sparkybrit/sram-breadboard-adapter/sram-breadboard-adaptor.kicad_pcb

## KiCad design sram-breadboard-adaptor.kicad_pcb (2026-11-08)

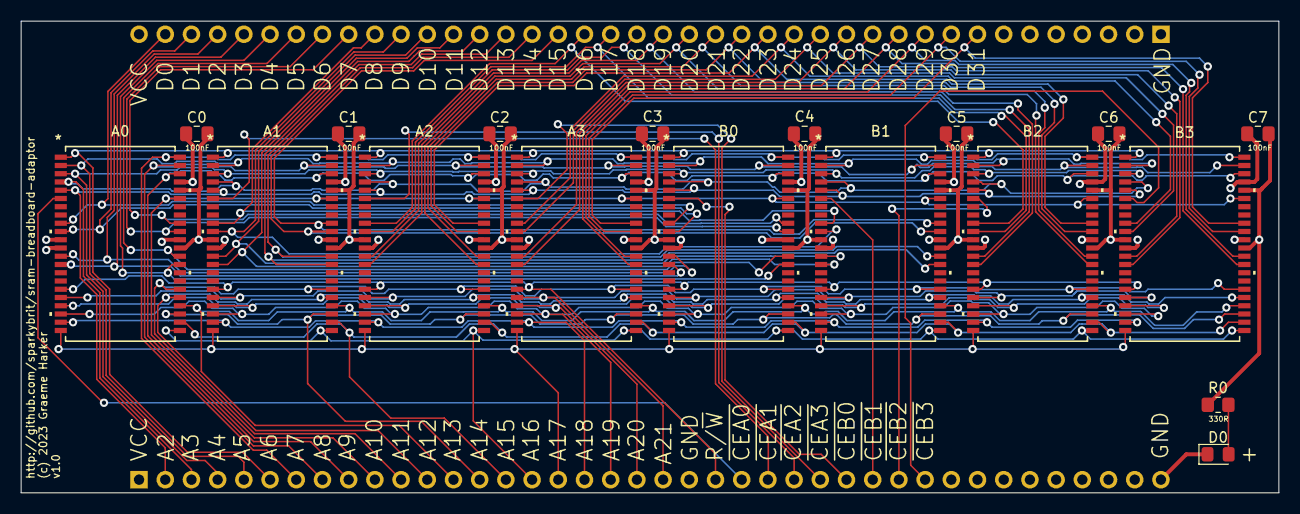
[picture p1: board sram-breadboard-adaptor.kicad_pcb from above]

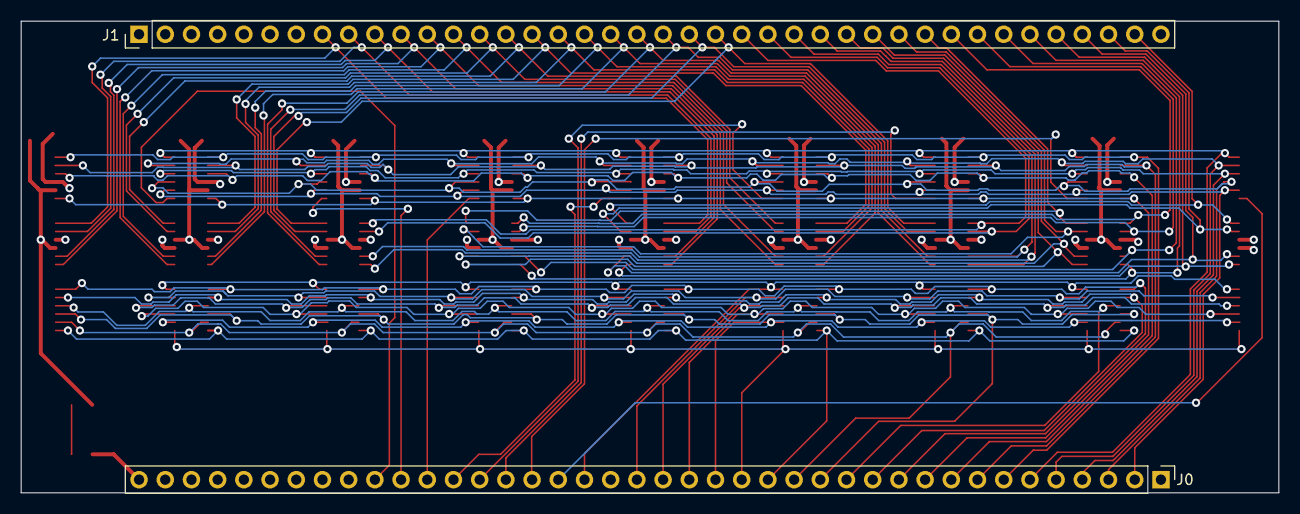
[picture p2: board sram-breadboard-adaptor.kicad_pcb from below]

Board: 4 copper layers, 121.9 x 45.7 mm, 20 parts (2 on the bottom side), 64 nets.

Parts:
A0, A1, A2, A3: LY62W10248ML-55LLI; TSOP-II-44_400MIL_LTK
B0, B1, B2, B3: LY62W10248ML-55LLI; TSOP-II-44_400MIL_LTK
C0, C2, C3, C4, C5, C6, C7: 100nF; C_0805_2012Metric_Pad1.18x1.45mm_HandSolder
C1: 110nF; C_0805_2012Metric_Pad1.18x1.45mm_HandSolder
D0: LED; LED_0805_2012Metric_Pad1.15x1.40mm_HandSolder
J0, J1: Conn_01x40; PinHeader_1x40_P2.54mm_Vertical
R0: 330R; R_0805_2012Metric_Pad1.20x1.40mm_HandSolder

Connections:
+5V: A0.11 (VCC), A0.33 (VCC), A0.40 (CE2), A1.11 (VCC), A1.33 (VCC), A1.40 (CE2), A2.11 (VCC), A2.33 (VCC), A2.40 (CE2), A3.11 (VCC), A3.33 (VCC), A3.40 (CE2), B0.11 (VCC), B0.33 (VCC), B0.40 (CE2), B1.11 (VCC), B1.33 (VCC), B1.40 (CE2), B2.11 (VCC), B2.33 (VCC), B2.40 (CE2), B3.11 (VCC), B3.33 (VCC), B3.40 (CE2), C0.1, C1.1, C2.1, C3.1, C4.1, C5.1, C6.1, C7.1, J0.1, J1.40, R0.1
/A2: A0.5 (A0), A1.5 (A0), A2.5 (A0), A3.5 (A0), B0.5 (A0), B1.5 (A0), B2.5 (A0), B3.5 (A0), J0.2
/A3: A0.4 (A1), A1.4 (A1), A2.4 (A1), A3.4 (A1), B0.4 (A1), B1.4 (A1), B2.4 (A1), B3.4 (A1), J0.3
/A4: A0.3 (A2), A1.3 (A2), A2.3 (A2), A3.3 (A2), B0.3 (A2), B1.3 (A2), B2.3 (A2), B3.3 (A2), J0.4
/A5: A0.2 (A3), A1.2 (A3), A2.2 (A3), A3.2 (A3), B0.2 (A3), B1.2 (A3), B2.2 (A3), B3.2 (A3), J0.5
/A6: A0.1 (A4), A1.1 (A4), A2.1 (A4), A3.1 (A4), B0.1 (A4), B1.1 (A4), B2.1 (A4), B3.1 (A4), J0.6
/A7: A0.44 (A5), A1.44 (A5), A2.44 (A5), A3.44 (A5), B0.44 (A5), B1.44 (A5), B2.44 (A5), B3.44 (A5), J0.7
/A8: A0.43 (A6), A1.43 (A6), A2.43 (A6), A3.43 (A6), B0.43 (A6), B1.43 (A6), B2.43 (A6), B3.43 (A6), J0.8
/A9: A0.42 (A7), A1.42 (A7), A2.42 (A7), A3.42 (A7), B0.42 (A7), B1.42 (A7), B2.42 (A7), B3.42 (A7), J0.9
/A10: A0.39 (A8), A1.39 (A8), A2.39 (A8), A3.39 (A8), B0.39 (A8), B1.39 (A8), B2.39 (A8), B3.39 (A8), J0.10
/A11: A0.28 (A9), A1.28 (A9), A2.28 (A9), A3.28 (A9), B0.28 (A9), B1.28 (A9), B2.28 (A9), B3.28 (A9), J0.11
/A12: A0.27 (A10), A1.27 (A10), A2.27 (A10), A3.27 (A10), B0.27 (A10), B1.27 (A10), B2.27 (A10), B3.27 (A10), J0.12
/A13: A0.26 (A11), A1.26 (A11), A2.26 (A11), A3.26 (A11), B0.26 (A11), B1.26 (A11), B2.26 (A11), B3.26 (A11), J0.13
/A14: A0.25 (A12), A1.25 (A12), A2.25 (A12), A3.25 (A12), B0.25 (A12), B1.25 (A12), B2.25 (A12), B3.25 (A12), J0.14
/A15: A0.24 (A13), A1.24 (A13), A2.24 (A13), A3.24 (A13), B0.24 (A13), B1.24 (A13), B2.24 (A13), B3.24 (A13), J0.15
/A16: A0.23 (A14), A1.23 (A14), A2.23 (A14), A3.23 (A14), B0.23 (A14), B1.23 (A14), B2.23 (A14), B3.23 (A14), J0.16
/A17: A0.22 (A15), A1.22 (A15), A2.22 (A15), A3.22 (A15), B0.22 (A15), B1.22 (A15), B2.22 (A15), B3.22 (A15), J0.17
/A18: A0.21 (A16), A1.21 (A16), A2.21 (A16), A3.21 (A16), B0.21 (A16), B1.21 (A16), B2.21 (A16), B3.21 (A16), J0.18
/A19: A0.20 (A17), A1.20 (A17), A2.20 (A17), A3.20 (A17), B0.20 (A17), B1.20 (A17), B2.20 (A17), B3.20 (A17), J0.19
/A20: A0.19 (A18), A1.19 (A18), A2.19 (A18), A3.19 (A18), B0.19 (A18), B1.19 (A18), B2.19 (A18), B3.19 (A18), J0.20
/A21: A0.18 (A19), A1.18 (A19), A2.18 (A19), A3.18 (A19), B0.18 (A19), B1.18 (A19), B2.18 (A19), B3.18 (A19), J0.21
/D0: A0.9 (DQ0), B0.9 (DQ0), J1.39
/D1: A0.10 (DQ1), B0.10 (DQ1), J1.38
/D2: A0.13 (DQ2), B0.13 (DQ2), J1.37
/D3: A0.14 (DQ3), B0.14 (DQ3), J1.36
/D4: A0.31 (DQ4), B0.31 (DQ4), J1.35
/D5: A0.32 (DQ5), B0.32 (DQ5), J1.34
/D6: A0.35 (DQ6), B0.35 (DQ6), J1.33
/D7: A0.36 (DQ7), B0.36 (DQ7), J1.32
/D8: A1.9 (DQ0), B1.9 (DQ0), J1.31
/D9: A1.10 (DQ1), B1.10 (DQ1), J1.30
/D10: A1.13 (DQ2), B1.13 (DQ2), J1.29
/D11: A1.14 (DQ3), B1.14 (DQ3), J1.28
/D12: A1.31 (DQ4), B1.31 (DQ4), J1.27
/D13: A1.32 (DQ5), B1.32 (DQ5), J1.26
/D14: A1.35 (DQ6), B1.35 (DQ6), J1.25
/D15: A1.36 (DQ7), B1.36 (DQ7), J1.24
/D16: A2.9 (DQ0), B2.9 (DQ0), J1.23
/D17: A2.10 (DQ1), B2.10 (DQ1), J1.22
/D18: A2.13 (DQ2), B2.13 (DQ2), J1.21
/D19: A2.14 (DQ3), B2.14 (DQ3), J1.20
/D20: A2.31 (DQ4), B2.31 (DQ4), J1.19
/D21: A2.32 (DQ5), B2.32 (DQ5), J1.18
/D22: A2.35 (DQ6), B2.35 (DQ6), J1.17
/D23: A2.36 (DQ7), B2.36 (DQ7), J1.16
/D24: A3.9 (DQ0), B3.9 (DQ0), J1.15
/D25: A3.10 (DQ1), B3.10 (DQ1), J1.14
/D26: A3.13 (DQ2), B3.13 (DQ2), J1.13
/D27: A3.14 (DQ3), B3.14 (DQ3), J1.12
/D28: A3.31 (DQ4), B3.31 (DQ4), J1.11
/D29: A3.32 (DQ5), B3.32 (DQ5), J1.10
/D30: A3.35 (DQ6), B3.35 (DQ6), J1.9
/D31: A3.36 (DQ7), B3.36 (DQ7), J1.8
/R/W: A0.17 (WE#), A1.17 (WE#), A2.17 (WE#), A3.17 (WE#), B0.17 (WE#), B1.17 (WE#), B2.17 (WE#), B3.17 (WE#), J0.23
/~CEA0: A0.6 (CE#), J0.24
/~CEA1: A1.6 (CE#), J0.25
/~CEA2: A2.6 (CE#), J0.26
/~CEA3: A3.6 (CE#), J0.27
/~CEB0: B0.6 (CE#), J0.28
/~CEB1: B1.6 (CE#), J0.29
/~CEB2: B2.6 (CE#), J0.30
/~CEB3: B3.6 (CE#), J0.31
GND: A0.12 (VSS), A0.34 (VSS), A0.41 (OE#), A1.12 (VSS), A1.34 (VSS), A1.41 (OE#), A2.12 (VSS), A2.34 (VSS), A2.41 (OE#), A3.12 (VSS), A3.34 (VSS), A3.41 (OE#), B0.12 (VSS), B0.34 (VSS), B0.41 (OE#), B1.12 (VSS), B1.34 (VSS), B1.41 (OE#), B2.12 (VSS), B2.34 (VSS), B2.41 (OE#), B3.12 (VSS), B3.34 (VSS), B3.41 (OE#), C0.2, C1.2, C2.2, C3.2, C4.2, C5.2, C6.2, C7.2, D0.1 (K), J0.22, J0.40, J1.1
unnamed: D0.2 (A), R0.2
