sparkybrit/sram-breadboard-adapter/(commit log)

2026-11-08 Migrate to KiCad 10 file format
    kicad-cli sch/pcb/sym/fp upgrade (KiCad 10.0.7). Netlist identical before and
    after (452 pins, 20 parts); DRC unchanged (57 violations, all silkscreen,
    text and library-copy warnings that predate the migration).
    [sram-breadboard-adaptor.kicad_pcb, sram-breadboard-adaptor.kicad_sch]
2026-11-08 Add sparky1-modules as a submodule, for this board's interface symbol
    lib/sparky1-modules holds SRAM_ADAPTER, generated from this schematic's J0
    and J1. Before committing a change to either connector, run
    cd lib/sparky1-modules && uv run --no-project python -I tools/check.py SRAM_ADAPTER ../..
2026-11-10 Keep this board's module symbol here, checked against its schematic
    module/ holds this board as a module of a larger schematic: modules.toml, the
    interface read from the schematic's J0 and J1, and the one-symbol library sram-breadboard-adapter.kicad_sym built from it.
    `make -C module` regenerates them and `make -C module check` fails if the
    symbol and the source disagree. The tools come from the kicad-tools
    submodule, which replaces sparky1-modules (Sparky1 now pins this repo
    itself and takes the library from here).
2026-11-10 kicad-tools: leave the .kicad_prl as it was
2026-11-10 Stop tracking the .kicad_prl
    It holds only per-user view settings (visible layers, opacity), and
    KiCad rewrites it whenever the board is opened.
2026-11-13 README: little-endian lane numbering and the hand-fitted bypass capacitors
