sparkybrit/sram-breadboard-adapter/(notices)

Notices in the files:
sram-breadboard-adaptor.kicad_pcb:
(c) 2023 Graeme Harker
